curiouselectric/CO2Monitor/INSTRUCTIONS/cheese_board_pcb.png

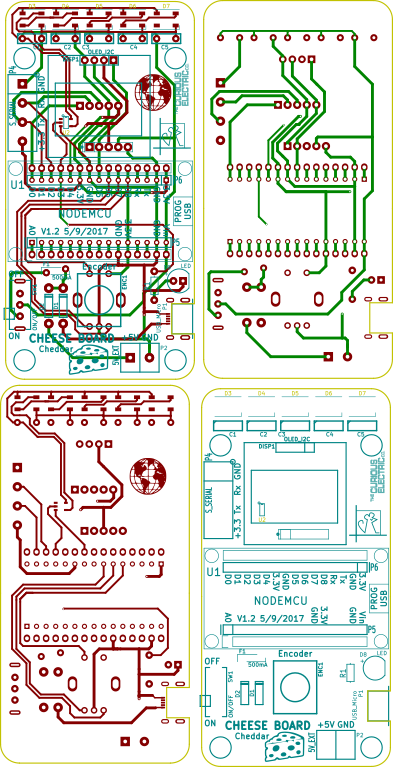
INSTRUCTIONS/cheese_board_pcb.png
