curiouselectric/CO2Monitor/README.md

# CO2Monitor
A carbon dioxide monitor for room level CO2 measuring. Using ESP8266. WiFi enabled
