curiouselectric/CO2Monitor/HARDWARE/CheeseBoard_Hardware/CheeseBoardCheddar_Hardware/Cheese Board Cheddar Enclosure Design_v2.dxf

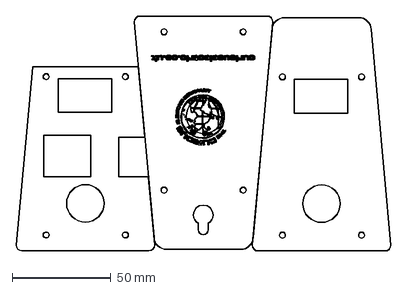
[picture p2: CAD file, 2021-05-28]
HARDWARE/CheeseBoard_Hardware/CheeseBoardCheddar_Hardware/Cheese Board Cheddar Enclosure Design_v2.dxf
189.4 x 118.8 mm
