curiouselectric/CO2Monitor/HARDWARE/CheeseBoard_Hardware/CheeseBoardCheddar_Hardware/OLD designs/Cheese Board Cheddar Enclosure Design.dxf

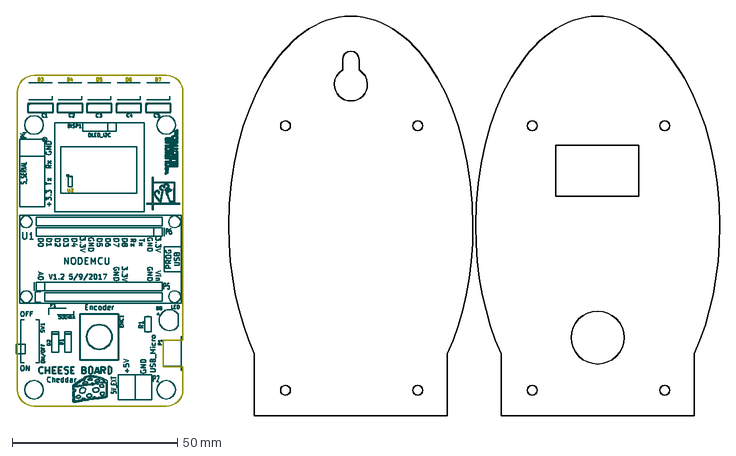
[picture p3: CAD file, 2021-05-28, an earlier design]
HARDWARE/CheeseBoard_Hardware/CheeseBoardCheddar_Hardware/OLD designs/Cheese Board Cheddar Enclosure Design.dxf
212.7 x 120.8 mm
