curiouselectric/CO2Monitor/INSTRUCTIONS/Button Flow Code.png

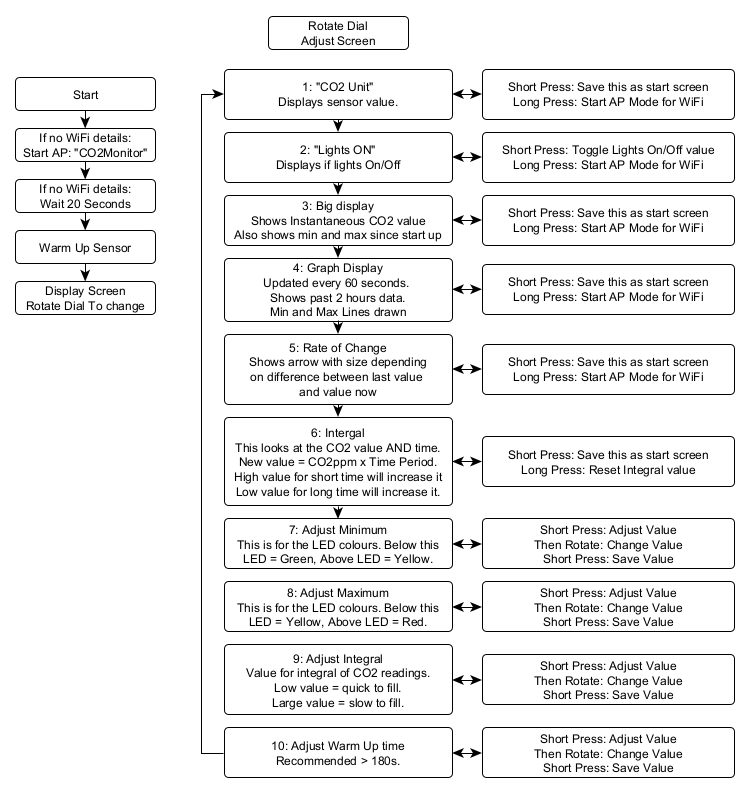
INSTRUCTIONS/Button Flow Code.png
