curiouselectric/CO2Monitor/INSTRUCTIONS/cheese_board_schematic_pdf.pdf

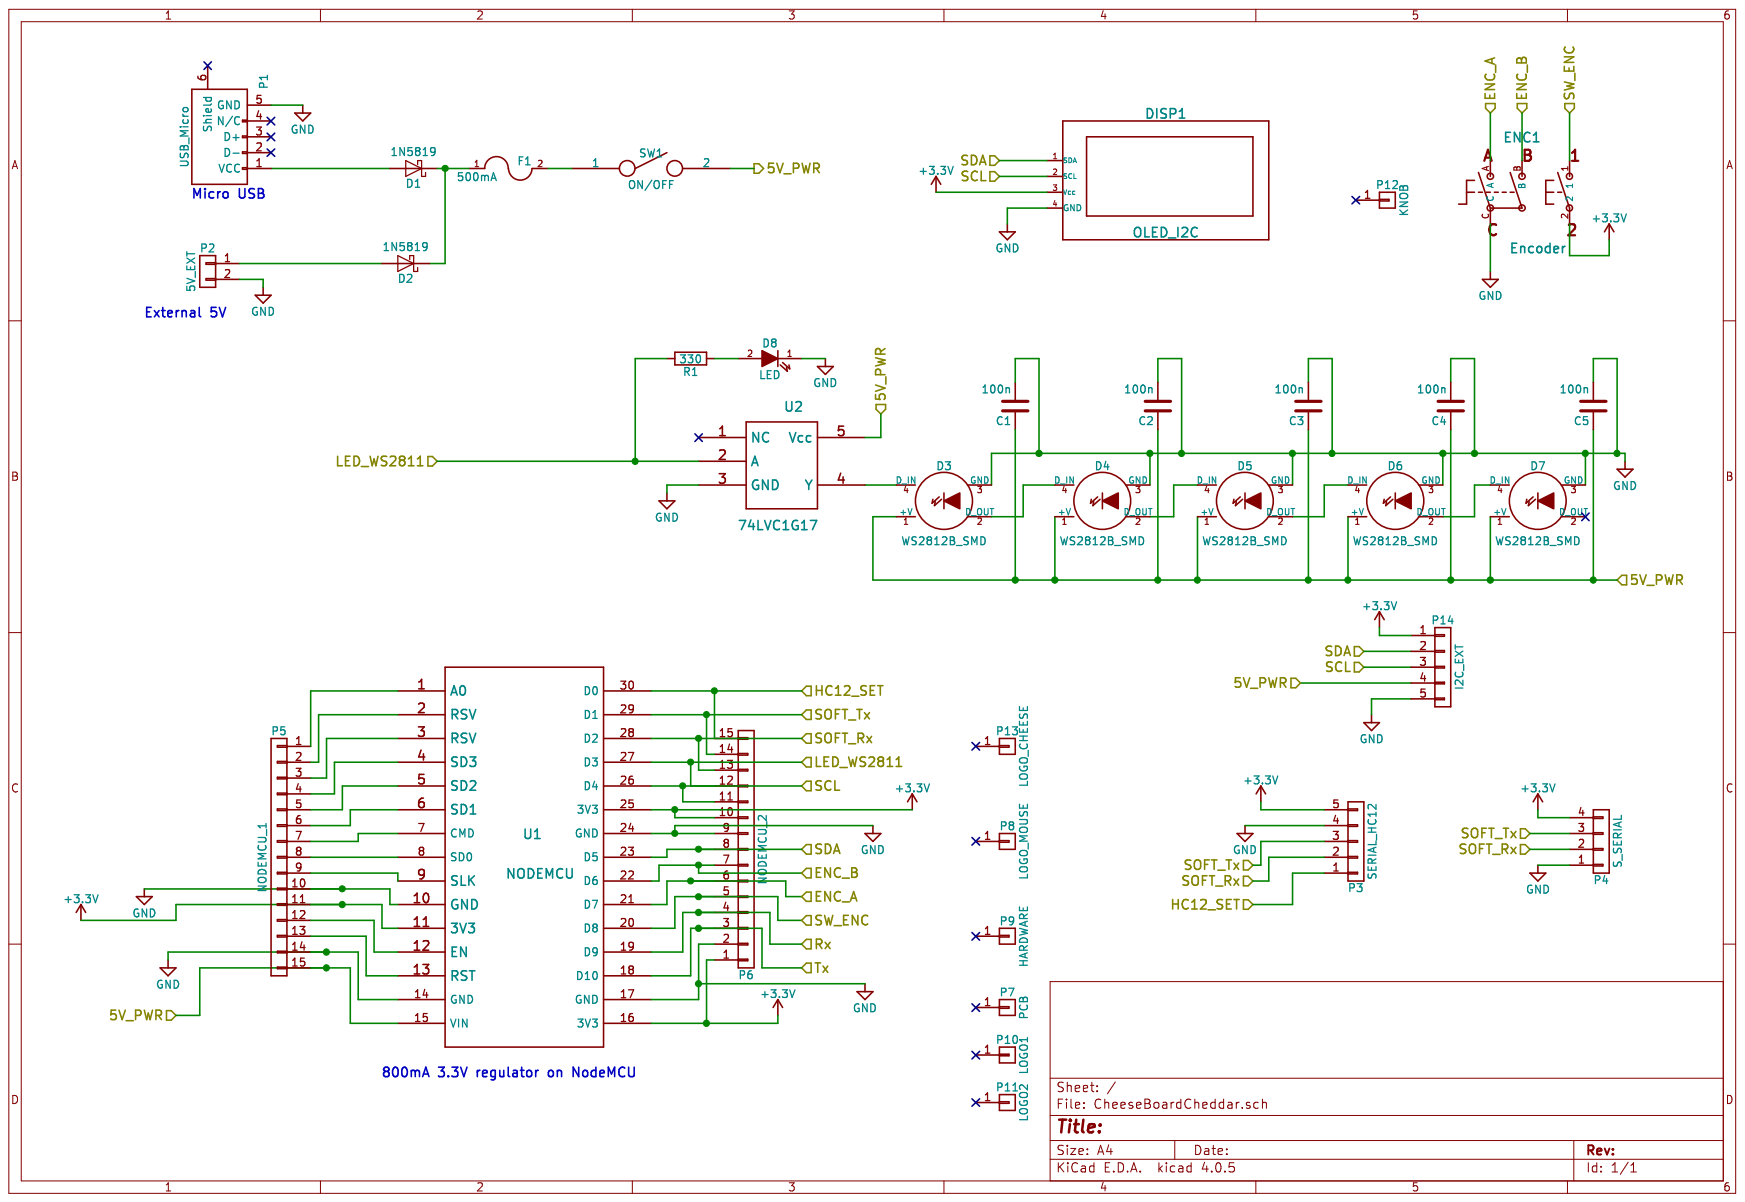
[picture p30: page 1]
