curiouselectric/CO2Monitor/HARDWARE/CheeseBoard_Hardware/CheeseBoardCheddar_PCB/CheeseBoardCheddar.kicad_pcb

## KiCad design HARDWARE/CheeseBoard_Hardware/CheeseBoardCheddar_PCB/CheeseBoardCheddar.kicad_pcb (2021-05-28)

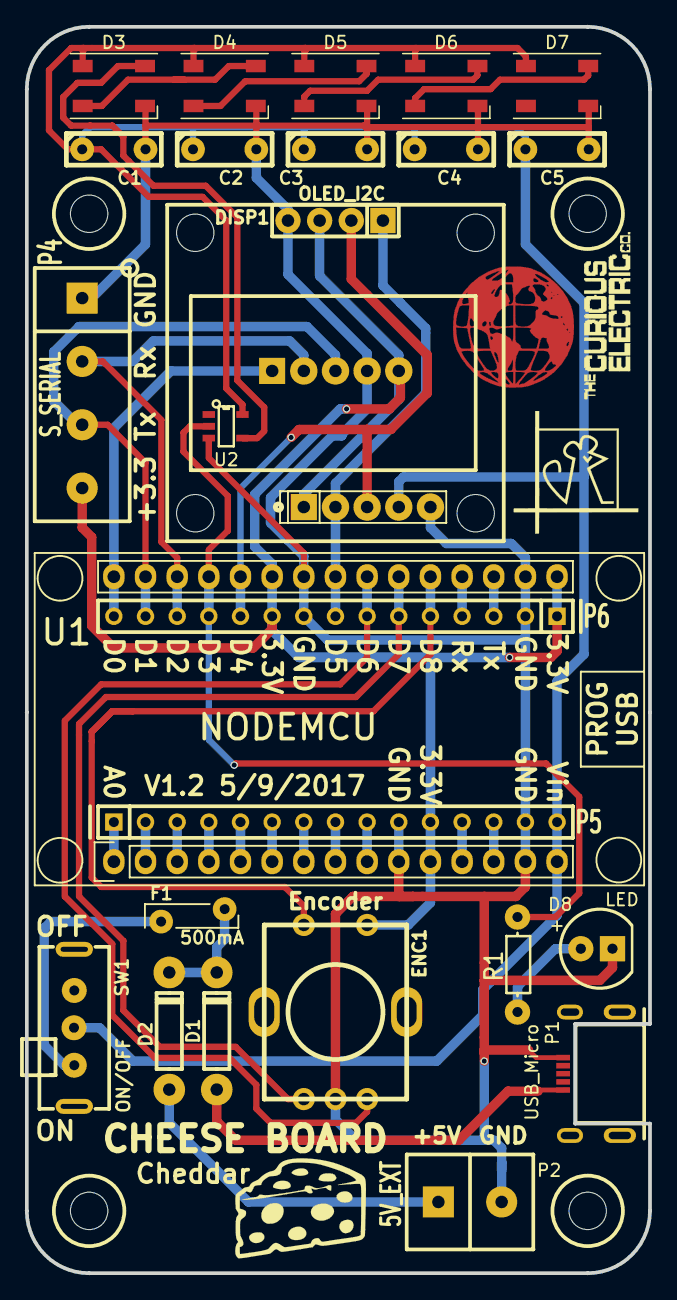
[picture p31: board CheeseBoardCheddar.kicad_pcb from above]

Board: 2 copper layers, 50.0 x 100.0 mm, 32 parts (0 on the bottom side), 35 nets.

Parts:
C1, C2, C3, C4, C5: 100n; C1_wide_lg_pad
D1, D2: 1N5819; TH_Diode_1
D3, D4, D5, D6, D7: WS2812B_SMD; SM_WS2812B
D8: LED; TH_LED-5MM_larg_pad
DISP1: OLED_I2C; TH_OLED1306
ENC1: Encoder; TH_Encoder
F1: 500mA; TH_MC36188_FUSE
P1: USB_Micro; USB_Micro-B_MOLEX_47642-0001
P2: 5V_EXT; SIL-2_screw_terminal
P3: SERIAL_HC12; TH_SIL_5_HC12
P4: S_SERIAL; SIL-4_screw_terminals
P5: NODEMCU_1; TH_SIL-15
P6: NODEMCU_2; TH_SIL-15
P7: PCB; PCB_50x100mm_RJWIFI
P8: LOGO_MOUSE; mouse10x10
P10: LOGO1; CEC_Globe_10mm_FCU
P11: LOGO2; TCEC_Words_13mm
P13: LOGO_CHEESE; CheeseWedge8mm
P14: I2C_EXT; SIL-5_large_pads_marker
R1: 330; TH_Resistor_1
SW1: ON/OFF; SW_SPDT_R_Angle_ALIEX
U1: NODEMCU; NodeMCU_Amica_R2_FSILK
U2: 74LVC1G17; SM_SOT-23-5

Connections:
+3V3: DISP1.3, ENC1.2, P3.5, P4.4, P5.11, P6.1, P6.10, P14.1, U1.11, U1.16, U1.25
/5V_PWR: C1.1, C2.1, C3.1, C4.1, C5.1, D3.1, D4.1, D5.1, D6.1, D7.1, P5.15, P14.4, SW1.2, U1.15, U2.5
/ENC_A: ENC1.A, P6.6, U1.21
/ENC_B: ENC1.B, P6.7, U1.22
/HC12_SET: P3.1, P6.15, U1.30
/LED_WS2811: P6.12, R1.1, U1.27, U2.2
/Rx: P6.4, U1.19
/SCL: DISP1.2, P6.11, P14.3, U1.26
/SDA: DISP1.1, P6.8, P14.2, U1.23
/SOFT_Rx: P3.2, P4.2, P6.13, U1.28
/SOFT_Tx: P3.3, P4.3, P6.14, U1.29
/SW_ENC: ENC1.1, P6.5, U1.20
/Tx: P6.3, U1.18
GND: C1.2, C2.2, C3.2, C4.2, C5.2, D3.3, D4.3, D5.3, D6.3, D7.3, D8.1, DISP1.4, ENC1.C, P1.5, P2.2, P3.4, P4.1, P5.10, P5.14, P6.2, P6.9, P14.5, U1.10, U1.14, U1.17, U1.24, U2.3
unnamed: D1.1, D2.1, F1.1
unnamed: D1.2, P1.1
unnamed: D2.2, P2.1
unnamed: D3.2, D4.4
unnamed: D3.4, U2.4
unnamed: D4.2, D5.4
unnamed: D5.2, D6.4
unnamed: D6.2, D7.4
unnamed: D8.2, R1.2
unnamed: F1.2, SW1.1
unnamed: P5.1, U1.1
unnamed: P5.2, U1.2
unnamed: P5.3, U1.3
unnamed: P5.4, U1.4
unnamed: P5.5, U1.5
unnamed: P5.6, U1.6
unnamed: P5.7, U1.7
unnamed: P5.8, U1.8
unnamed: P5.9, U1.9
unnamed: P5.12, U1.12
unnamed: P5.13, U1.13
