curiouselectric/CO2Monitor/FIRMWARE/CO2monitor_eeprom_clear/CO2monitor_eeprom_clear.ino

/*
   EEPROM Clear

   Sets all of the bytes of the EEPROM to 0.
   This example code is in the public domain.

*/

#include <EEPROM.h>

void setup() {
  EEPROM.begin(512);
  // write a 0 to all 512 bytes of the EEPROM
  for (int i = 0; i < 512; i++) {
    EEPROM.write(i, 0);
  }
  EEPROM.end();
}

void loop() {
}
