curiouselectric/CO2Monitor/(commit log)

2021-05-28 Initial commit of main files
    [Cheese Board Cheddar Enclosure Design.dxf, Cheese Board Cheddar Enclosure Design_v2.dxf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]
2021-05-29 Updated code for deployment. Design of cut outs updated
2021-06-24 updated instructions
    Added calibration
